TheSuraj007/Internship_Work/Axial Load Tester/Load cell Final Code.png

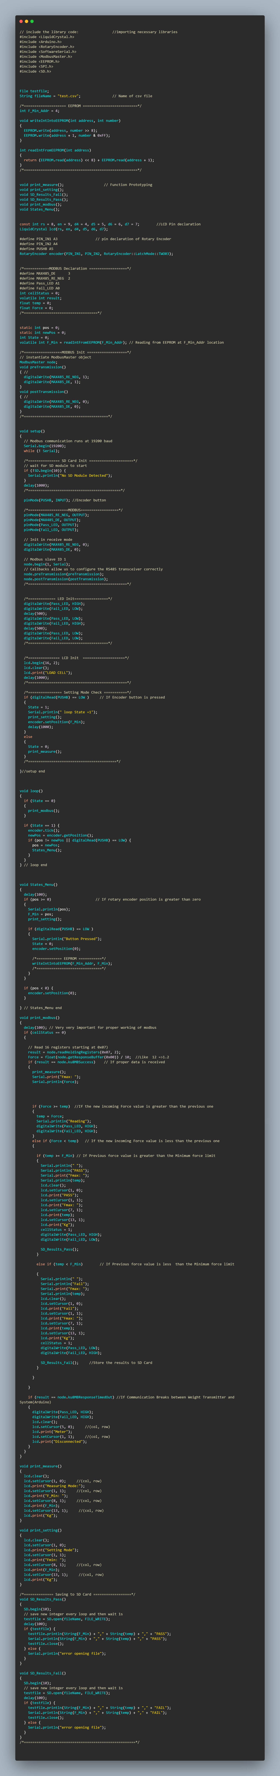
Axial Load Tester/Load cell Final Code.png
