TheSuraj007/Internship_Work/DC_Motor_Speed_PID_Control/Interrupt/Interrupt.ino

const byte ledPin = 13;
const byte interruptPin = 2;
volatile byte state = LOW;

void setup() {
  pinMode(ledPin, OUTPUT);
  pinMode(interruptPin, INPUT_PULLUP);
  attachInterrupt(digitalPinToInterrupt(interruptPin), blink, FALLING);
}

void loop() {
  digitalWrite(ledPin, state);
}

void blink() {
  state = !state;
}
